Sacha-Cantat/Batonome/Girouette/Support _aimant (réparée).stl

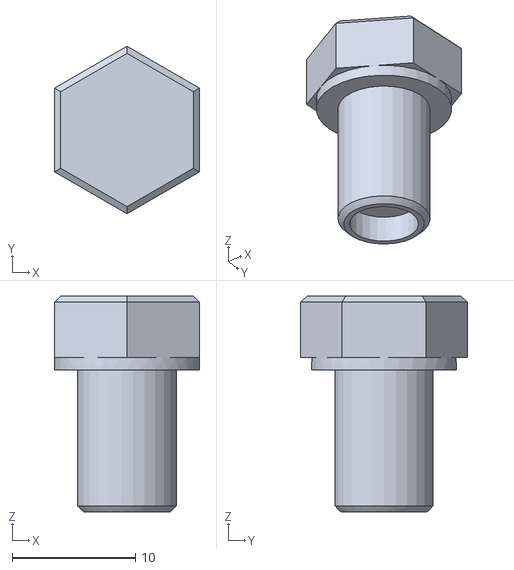
[picture p22: CAD file, 2023-05-26]
Girouette/Support _aimant (réparée).stl
11.8 x 13.6 x 17.5
