Sacha-Cantat/Batonome/Girouette/Entretoise.stl

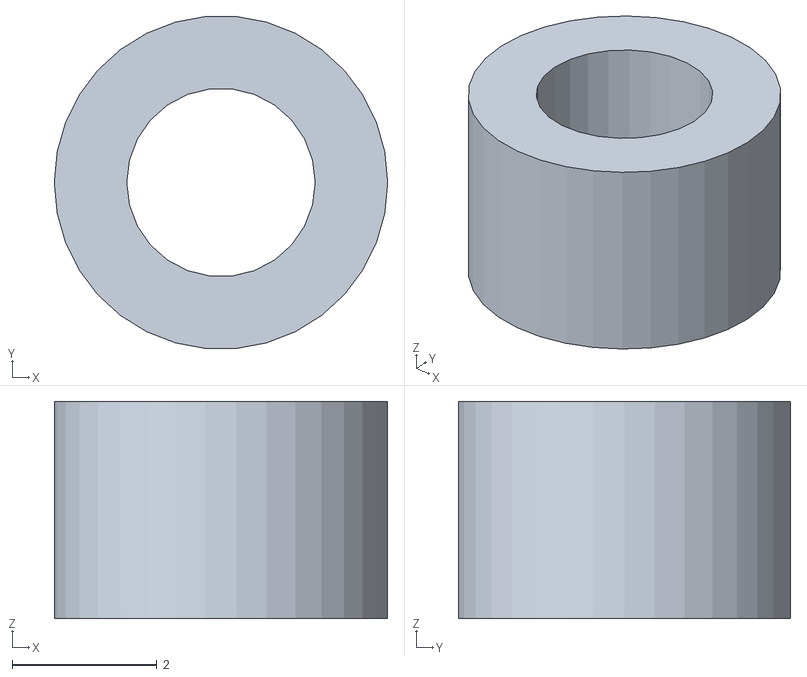
[picture p23: CAD file, 2023-05-26]
Girouette/Entretoise.stl
4.60 x 4.58 x 3.00
