Sacha-Cantat/Batonome/Girouette/Support _roulement.stl

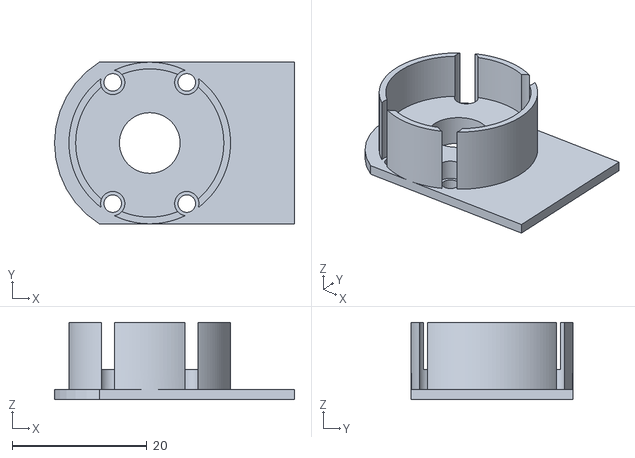
[picture p24: CAD file, 2023-05-26]
Girouette/Support _roulement.stl
35.7 x 24.0 x 11.5
