Sacha-Cantat/Batonome/Girouette/Girouette.stl

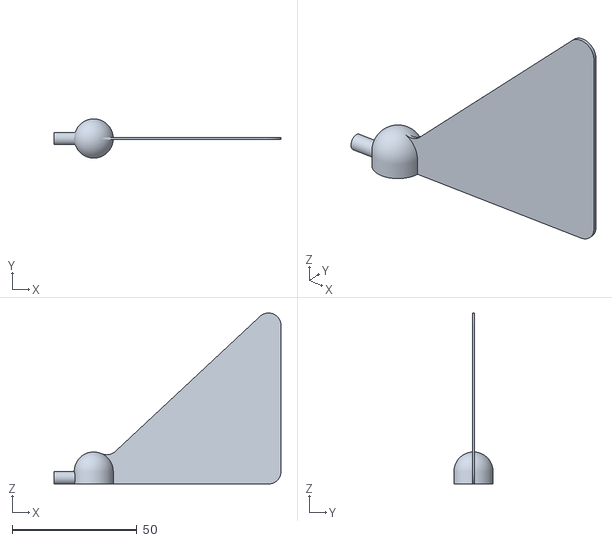
[picture p25: CAD file, 2023-05-26]
Girouette/Girouette.stl
90.9 x 15.7 x 68.5
