Sacha-Cantat/Batonome/Girouette/Support _AS5600L-BodyFillet001.stl

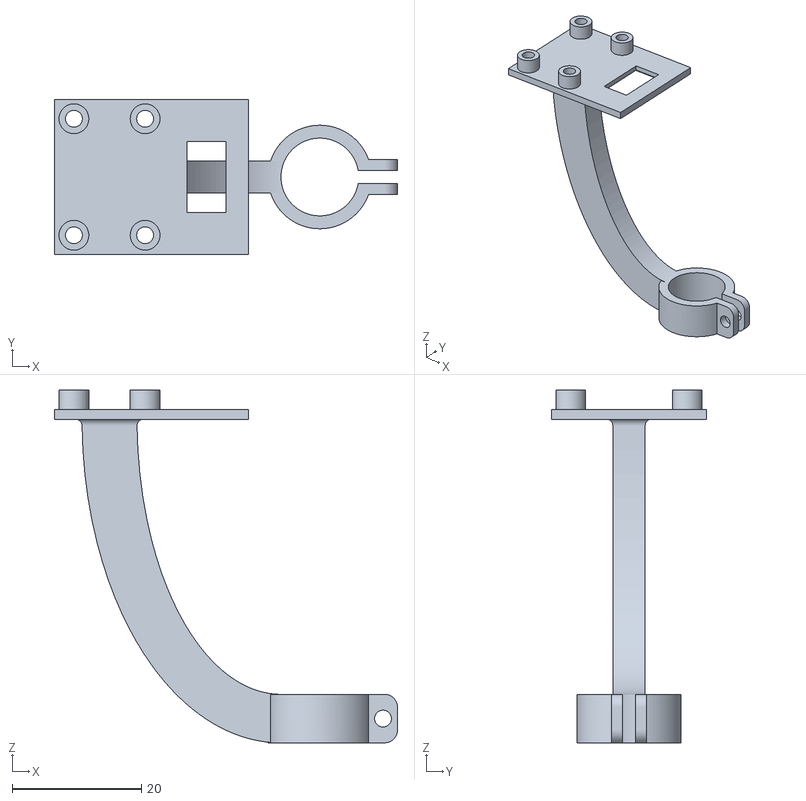
[picture p26: CAD file, 2023-05-26]
Girouette/Support _AS5600L-BodyFillet001.stl
53.0 x 24.0 x 54.5
