Sacha-Cantat/Batonome/Girouette/Girouette (réparée).stl

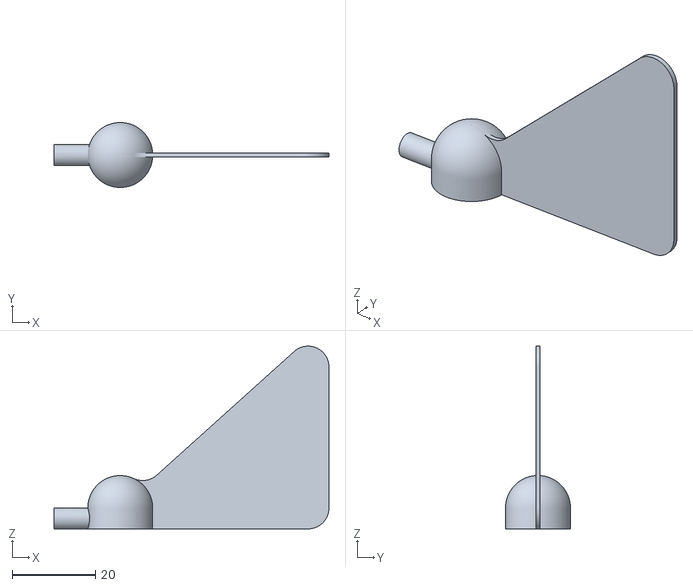
[picture p27: CAD file, 2023-05-26]
Girouette/Girouette (réparée).stl
65.9 x 15.6 x 43.8
