Sacha-Cantat/Batonome/(list of files, cad)

Other CAD files:
Girouette/Support _aimant.stl
Girouette/Support _roulement (réparée).stl
Girouette/Support _AS5600L-BodyFillet001 (réparée).stl
Girouette/Entretoise (réparée).stl
