Sacha-Cantat/Batonome/Carte de sûreté/PCB_BATO.kicad_pcb

## KiCad design Carte de sûreté/PCB_BATO.kicad_pcb (2023-05-26)

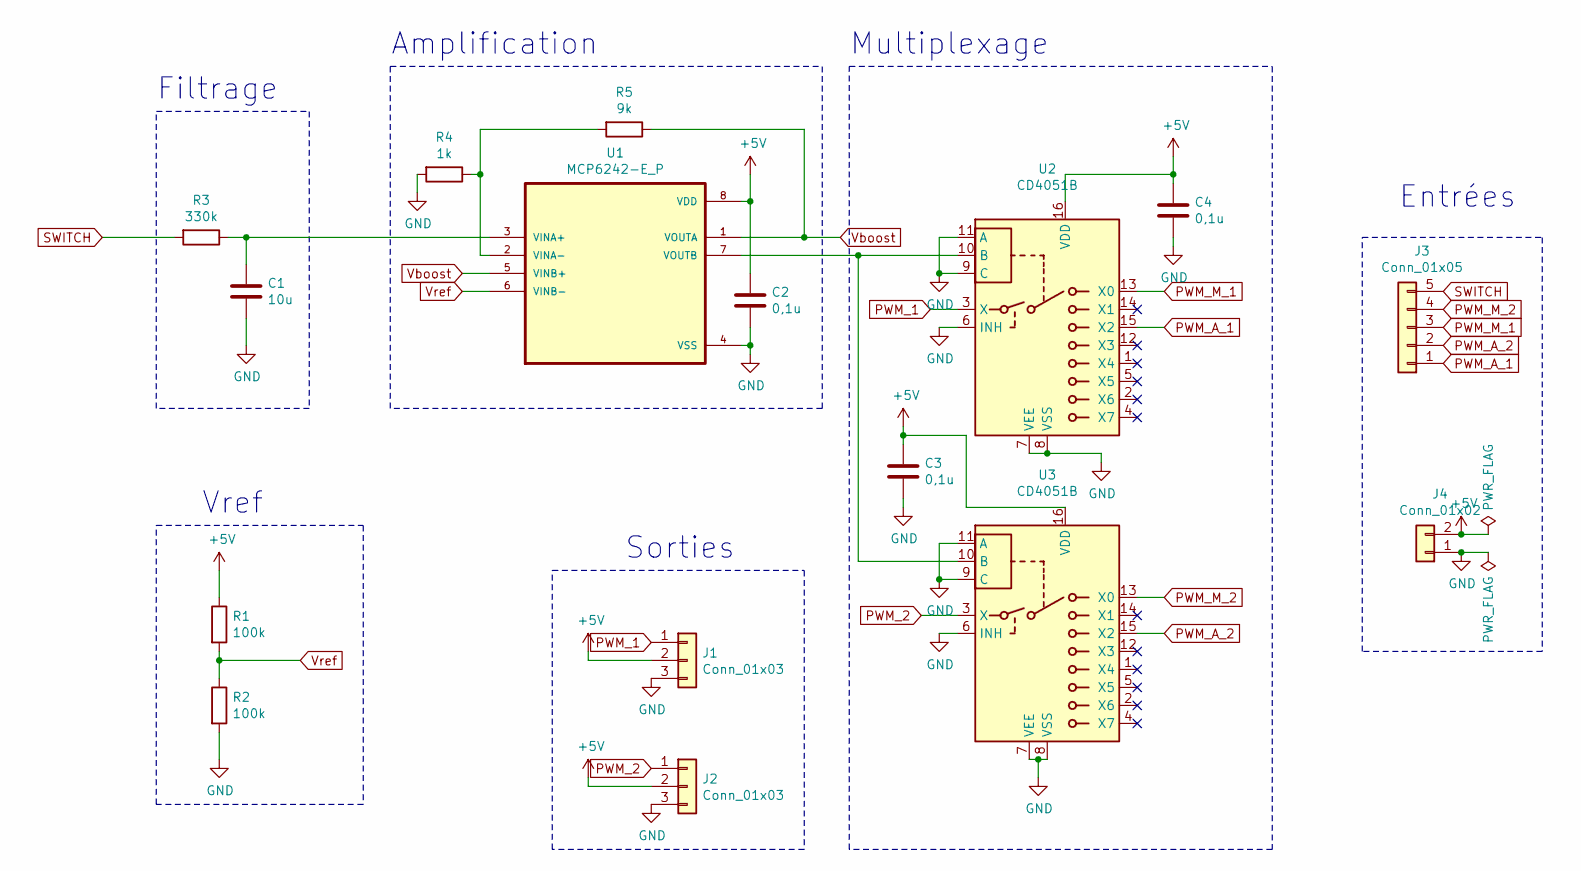
[picture p28: schematic PCB_BATO.sch]

Parts:
C1: 10u; C_Radial_D6.3mm_H7.0mm_P2.50mm
C2, C3, C4: 0,1u; C_Disc_D5.0mm_W2.5mm_P2.50mm
J1, J2: Conn_01x03; TerminalBlock_Phoenix_MKDS-1,5-3-5.08_1x03_P5.08mm_Horizont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
J3: Conn_01x05; TerminalBlock_Phoenix_MKDS-1,5-5-5.08_1x05_P5.08mm_Horizont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
J4: Conn_01x02; TerminalBlock_Phoenix_MKDS-1,5-2-5.08_1x02_P5.08mm_Horizont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
R1, R2: 100k; R_Axial_DIN0207_L6.3mm_D2.5mm_P15.24mm_Horizontal
R3: 330k; R_Axial_DIN0207_L6.3mm_D2.5mm_P15.24mm_Horizontal
R4: 1k; R_Axial_DIN0207_L6.3mm_D2.5mm_P15.24mm_Horizontal
R5: 9k; R_Axial_DIN0207_L6.3mm_D2.5mm_P15.24mm_Horizontal
U1: MCP6242-E_P; DIP787W46P254L927H533Q8
U2, U3: CD4051B; DIP794W45P254L1969H508Q16

Connections:
+5V: C2.1, C3.1, C4.1, J1.2, J2.2, J4.2, R1.1, U1.8 (VDD), U2.16 (VDD), U3.16 (VDD)
GND: C1.2, C2.2, C3.2, C4.2, J1.3, J2.3, J4.1, R2.2, R4.2, U1.4 (VSS), U2.6 (INH), U2.7 (VEE), U2.8 (VSS), U2.9 (C), U2.11 (A), U3.6 (INH), U3.7 (VEE), U3.8 (VSS), U3.9 (C), U3.11 (A)
unnamed: C1.1, R3.1, U1.3 (VINA+)
unnamed: R4.1, R5.2, U1.2 (VINA-)
unnamed: U1.7 (VOUTB), U2.10 (B), U3.10 (B)
PWM_1: J1.1, U2.3 (X)
PWM_2: J2.1, U3.3 (X)
PWM_A_1: J3.1, U2.15 (X2)
PWM_A_2: J3.2, U3.15 (X2)
PWM_M_1: J3.3, U2.13 (X0)
PWM_M_2: J3.4, U3.13 (X0)
SWITCH: J3.5, R3.2
Vboost: R5.1, U1.1 (VOUTA), U1.5 (VINB+)
Vref: R1.2, R2.1, U1.6 (VINB-)

Notes on the sheet:
Filtrage
Amplification
Multiplexage
Entrées
Sorties
Vref

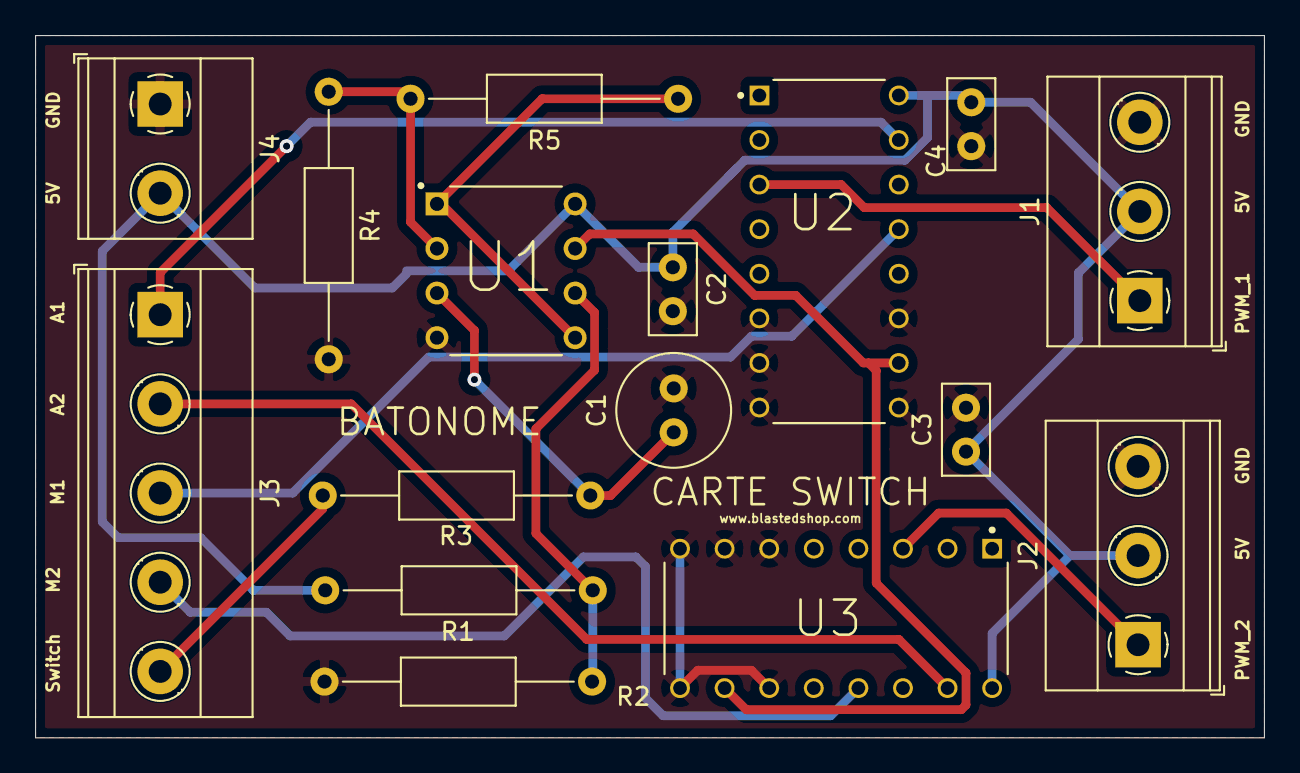
[picture p29: board PCB_BATO.kicad_pcb from above]

Board: 2 copper layers, 70.0 x 40.0 mm, 16 parts (0 on the bottom side), 14 nets.
