Sacha-Cantat/Batonome/Batonome-Embedded/Core/Src/main.c

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
/* Includes ------------------------------------------------------------------*/
#include "main.h"
#include "cmsis_os.h"

/* USER CODE BEGIN Includes */
#include <stdio.h>
/* USER CODE END Includes */

/* USER CODE BEGIN PD */
uint8_t UART1_rxBuffer[RX_BUFFER_SIZE] = {0};
uint8_t UART2_rxBuffer[RX_BUFFER_SIZE] = {0};

uint8_t UART1_txBuffer[RX_BUFFER_SIZE] = {0};
uint8_t rxDataZigbee;
uint8_t rxDataGPS;

float valVent[10];

int offset;

BatonomeStruct batonomeData;

BatonomeStructConf batonomeDataConf;


/* USER CODE END PD */

I2C_HandleTypeDef hi2c1;
I2C_HandleTypeDef hi2c3;

TIM_HandleTypeDef htim1;
TIM_HandleTypeDef htim2;
TIM_HandleTypeDef htim16;

UART_HandleTypeDef huart1;
UART_HandleTypeDef huart2;

/* Definitions for defaultTask */
osThreadId_t defaultTaskHandle;
const osThreadAttr_t defaultTask_attributes = {
  .name = "defaultTask",
  .stack_size = 128 * 4,
  .priority = (osPriority_t) osPriorityNormal,
};
void SystemClock_Config(void);
static void MX_GPIO_Init(void);
static void MX_I2C1_Init(void);
static void MX_I2C3_Init(void);
static void MX_USART1_UART_Init(void);
static void MX_USART2_UART_Init(void);
static void MX_TIM1_Init(void);
static void MX_TIM16_Init(void);
static void MX_TIM2_Init(void);
void StartDefaultTask(void *argument);

/* USER CODE BEGIN 0 */
#ifdef __GNUC__
#define PUTCHAR_PROTOTYPE int __io_putchar(int ch)
#else
#define PUTCHAR_PROTOTYPE int fputc(int ch, FILE *f)
#endif

PUTCHAR_PROTOTYPE
{
  //HAL_UART_Transmit(&huart2, (uint8_t *)&ch, 1, HAL_MAX_DELAY);
  return ch;
}


/*
void logPWM(const char *format, ...)
{
#ifdef PWMLOG
	va_list args;
	char new_format[100]; // Définissez la taille de la chaîne selon vos besoins
	sprintf(new_format, "PWMLOG : %s", format);
    va_start(args, format);
    vprintf(format, args);
    va_end(args);
#endif
}

void logZIGBEE(const char *format, ...)
{
#ifdef ZIGBEELOG
	va_list args;
	char new_format[100]; // Définissez la taille de la chaîne selon vos besoins
	sprintf(new_format, "ZIGBEELOG : %s", format);
	va_start(args, format);
	vprintf(format, args);
	va_end(args);
#endif
}

void logGPS(const char *format, ...)
{
#ifdef GPSLOG
	va_list args;
	char new_format[100]; // Définissez la taille de la chaîne selon vos besoins
	sprintf(new_format, "GPSLOG : %s", format);
	va_start(args, format);
	vprintf(format, args);
	va_end(args);
#endif

}

void logIMU(const char *format, ...)
{
#ifdef IMULOG
	va_list args;
	char new_format[100]; // Définissez la taille de la chaîne selon vos besoins
	sprintf(new_format, "IMULOG : %s", format);
	va_start(args, format);
	vprintf(format, args);
	va_end(args);
#endif
}*/
/* USER CODE END 0 */

/**
  * @brief  The application entry point.
  * @retval int
  */
int main(void)
{
  /* MCU Configuration--------------------------------------------------------*/

  /* Reset of all peripherals, Initializes the Flash interface and the Systick. */
  HAL_Init();

  /* Configure the system clock */
  SystemClock_Config();

  /* Initialize all configured peripherals */
  MX_GPIO_Init();
  MX_I2C1_Init();
  MX_I2C3_Init();
  MX_USART1_UART_Init();
  MX_USART2_UART_Init();
  MX_TIM1_Init();
  MX_TIM16_Init();
  MX_TIM2_Init();
  /* USER CODE BEGIN 2 */
  printf("Welcome BATONOME V1.0.0\n");
  //HAL_TIM_PWM_Start(&htim16,TIM_CHANNEL_1);
  //TIM16->CCR1 = 150;
  //gps_Init();
  imu_Init();
  navig_Init();
  //zigbee_Init();
  windSensor_Init();
  gestionPWM_Init();
  HAL_UART_Receive_IT (&huart1, &rxDataZigbee, 1);
  HAL_UART_Receive_IT (&huart2, &rxDataGPS, 1);


  /* USER CODE END 2 */

  /* Init scheduler */
  osKernelInitialize();

  /* USER CODE BEGIN RTOS_MUTEX */
  /* add mutexes, ... */
  /* USER CODE END RTOS_MUTEX */

  /* USER CODE BEGIN RTOS_SEMAPHORES */
  /* add semaphores, ... */
  /* USER CODE END RTOS_SEMAPHORES */

  /* USER CODE BEGIN RTOS_TIMERS */
  /* start timers, add new ones, ... */
  /* USER CODE END RTOS_TIMERS */

  /* USER CODE BEGIN RTOS_QUEUES */
  /* add queues, ... */
  /* USER CODE END RTOS_QUEUES */

  /* Create the thread(s) */
  /* creation of defaultTask */
  defaultTaskHandle = osThreadNew(StartDefaultTask, NULL, &defaultTask_attributes);

  /* USER CODE BEGIN RTOS_THREADS */


  /* add threads, ... */
  /* USER CODE END RTOS_THREADS */

  /* USER CODE BEGIN RTOS_EVENTS */
  /* add events, ... */
  /* USER CODE END RTOS_EVENTS */

  /* Start scheduler */
  osKernelStart();

  /* We should never get here as control is now taken by the scheduler */
  /* Infinite loop */
  /* USER CODE BEGIN WHILE */
  while (1)
  {
    /* USER CODE END WHILE */

    /* USER CODE BEGIN 3 */
  }
  /* USER CODE END 3 */
}

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
/* USER CODE BEGIN 4 */
void HAL_UART_RxCpltCallback(UART_HandleTypeDef *huart)
{
	if (huart->Instance == USART1) {
			zigbeeTxCpltCallback();
			//printf("%c",rxDataZigbee);
			//HAL_UART_Receive_IT (&huart1, &rxDataZigbee, 1);
		}
	if (huart->Instance == USART2) {
		GPS_RxCpltCallback();
			}
}

/* USER CODE END 4 */

/* USER CODE BEGIN Header_StartDefaultTask */
/**
  * @brief  Function implementing the defaultTask thread.
  * @param  argument: Not used
  * @retval None
  */
/* USER CODE END Header_StartDefaultTask */
void StartDefaultTask(void *argument)
{
  /* USER CODE BEGIN 5 */
  /* Infinite loop */
  for(;;)
  {
    osDelay(1);
	//PRINT("Step: 0\n");
	/*osDelay(2000);
	TIM1->CCR1 = 10;
	PRINT("Step: 10\n");
	osDelay(2000);
	TIM1->CCR1 = 20;
	PRINT("Step: 20\n");
	osDelay(2000);
	TIM1->CCR1 = 30;
	PRINT("Step: 30\n");
	osDelay(2000);
	TIM1->CCR1 = 40;
	PRINT("Step: 40\n");
	osDelay(2000);
	TIM1->CCR1 = 50;
	PRINT("Step: 50\n");
	osDelay(2000);
	TIM1->CCR1 = 60;
	PRINT("Step: 60\n");
	osDelay(2000);
	TIM1->CCR1 = 70;
	PRINT("Step: 70\n");
	osDelay(2000);
	TIM1->CCR1 = 80;
	PRINT("Step: 80\n");
	osDelay(2000);
	TIM1->CCR1 = 90;
	PRINT("Step: 90\n");
	osDelay(500);
	TIM1->CCR1 = 99;
	PRINT("Step: 99\n");
	osDelay(5000);*/
  }
  /* USER CODE END 5 */
}

/**
  * @brief  Period elapsed callback in non blocking mode
  * @note   This function is called  when TIM6 interrupt took place, inside
  * HAL_TIM_IRQHandler(). It makes a direct call to HAL_IncTick() to increment
  * a global variable "uwTick" used as application time base.
  * @param  htim : TIM handle
  * @retval None
  */
void HAL_TIM_PeriodElapsedCallback(TIM_HandleTypeDef *htim)
{
  if (htim->Instance == TIM6) {
    HAL_IncTick();
  }
}

/**
  * @brief  This function is executed in case of error occurrence.
  * @retval None
  */
void Error_Handler(void)
{
  /* USER CODE BEGIN Error_Handler_Debug */
  /* User can add his own implementation to report the HAL error return state */
  __disable_irq();
  while (1)
  {
  }
  /* USER CODE END Error_Handler_Debug */
}

#ifdef  USE_FULL_ASSERT
/**
  * @brief  Reports the name of the source file and the source line number
  *         where the assert_param error has occurred.
  * @param  file: pointer to the source file name
  * @param  line: assert_param error line source number
  * @retval None
  */
void assert_failed(uint8_t *file, uint32_t line)
{
  /* USER CODE BEGIN 6 */
  /* User can add his own implementation to report the file name and line number,
     ex: printf("Wrong parameters value: file %s on line %d\r\n", file, line) */
  /* USER CODE END 6 */
}
#endif /* USE_FULL_ASSERT */
