Sacha-Cantat/Batonome/Batonome-Embedded/Batonome-Embedded.ioc

Mcu.UserName=STM32L432KCUx
PA10.Signal=USART1_RX
PA11.Signal=S_TIM1_CH4
PA2.Signal=USART2_TX
PA3.Signal=USART2_RX
PA6.Signal=S_TIM16_CH1
PA7.Signal=I2C3_SCL
PA8.Signal=S_TIM1_CH1
PA9.Signal=USART1_TX
PB6.Signal=I2C1_SCL
PB7.Signal=I2C1_SDA
