Sacha-Cantat/Batonome/Batonome-Embedded/Core/Inc/main.h

#define RX_BUFFER_SIZE 80
#define PWMLOG 1
#define ZIGBEELOG 1
#define GPSLOG 1
#define IMULOG 1
