Sacha-Cantat/Batonome/Batonome-Embedded/Core/Inc/navig.h

/*
 * imu.h
 *
 *  Created on: 10 janv. 2023
 *      Author: scant
 */

#ifndef INC_NAVIG_H_
#define INC_NAVIG_H_

#include "main.h"
#include <stdio.h>


/* USER CODE END Includes */

void navigManagement();
void navig_Init();


#endif /* INC_NAVIG_H_ */
