Sacha-Cantat/Batonome/Batonome-Embedded/Core/Inc/imu.h

/*
 * imu.h
 *
 *  Created on: 10 janv. 2023
 *      Author: scant
 */

#ifndef INC_IMU_H_
#define INC_IMU_H_

#include "main.h"
#include <stdio.h>

/* USER CODE END Includes */

void ImuManagement();
void imu_Init();


#endif /* INC_IMU_H_ */
