Sacha-Cantat/Batonome/(commit log)

2022-12-13 Document de spécification projet
2022-12-14 IHM Retour d'info Batonome et init de la zone de navigation
2022-12-14 Click de la sourie enregistre le point GPS dans un tuple
2022-12-14 passage de l'appli sous Ctkinter
2022-12-15 Saisie des infos GPS de la balise
2022-12-16 Enregistrement des coorodonés de la balise dans un tuple
2022-12-16 Une fois la zone de nav ok, on peut init la balise avec un clic souris
2023-01-04 Ajout barre de navigation sur la gauche
2023-01-05 Modif vitesse com uart1
2023-01-05 Uart 2 gps
2023-01-06 Lancement de la tâche IMU managment
2023-01-12 Uart en extern
2023-01-12 Ajout config i2C
2023-01-16 Switch to C++
2023-01-16 fix last commit issue
    [gps.c, gps.h, imu.c, imu.h, main.c, main.h, zigbee.c, zigbee.h]
2023-01-19 Emission serie toutes les secondes
2023-03-05 Ajout PWM
2023-03-05 Ahout des fichier de config gestionPWM
2023-03-07 Gestion de la dérive fonctionnelle
2023-03-07 Gestion de la derive par les touche du clavier
2023-05-25 IMU ok !
2023-05-26 Fichier carte de sûreté
    [PCB_BATO-B_Cu.gbr, PCB_BATO-B_Mask.gbr, PCB_BATO-B_Paste.gbr, PCB_BATO-B_SilkS.gbr, PCB_BATO-Edge_Cuts.gbr, PCB_BATO-F_Cu.gbr, PCB_BATO-F_Mask.gbr, PCB_BATO-F_Paste.gbr]
2023-05-26 STL Girouette
    [Entretoise (réparée).stl, Entretoise.stl, Girouette (réparée).stl, Girouette.stl, Support _AS5600L-BodyFillet001 (réparée).stl, Support _AS5600L-BodyFillet001.stl, Support _aimant (réparée).stl, Support _aimant.stl]
